cLLeB/lock-in-amplifier/breadboard/breadboard-layout.png

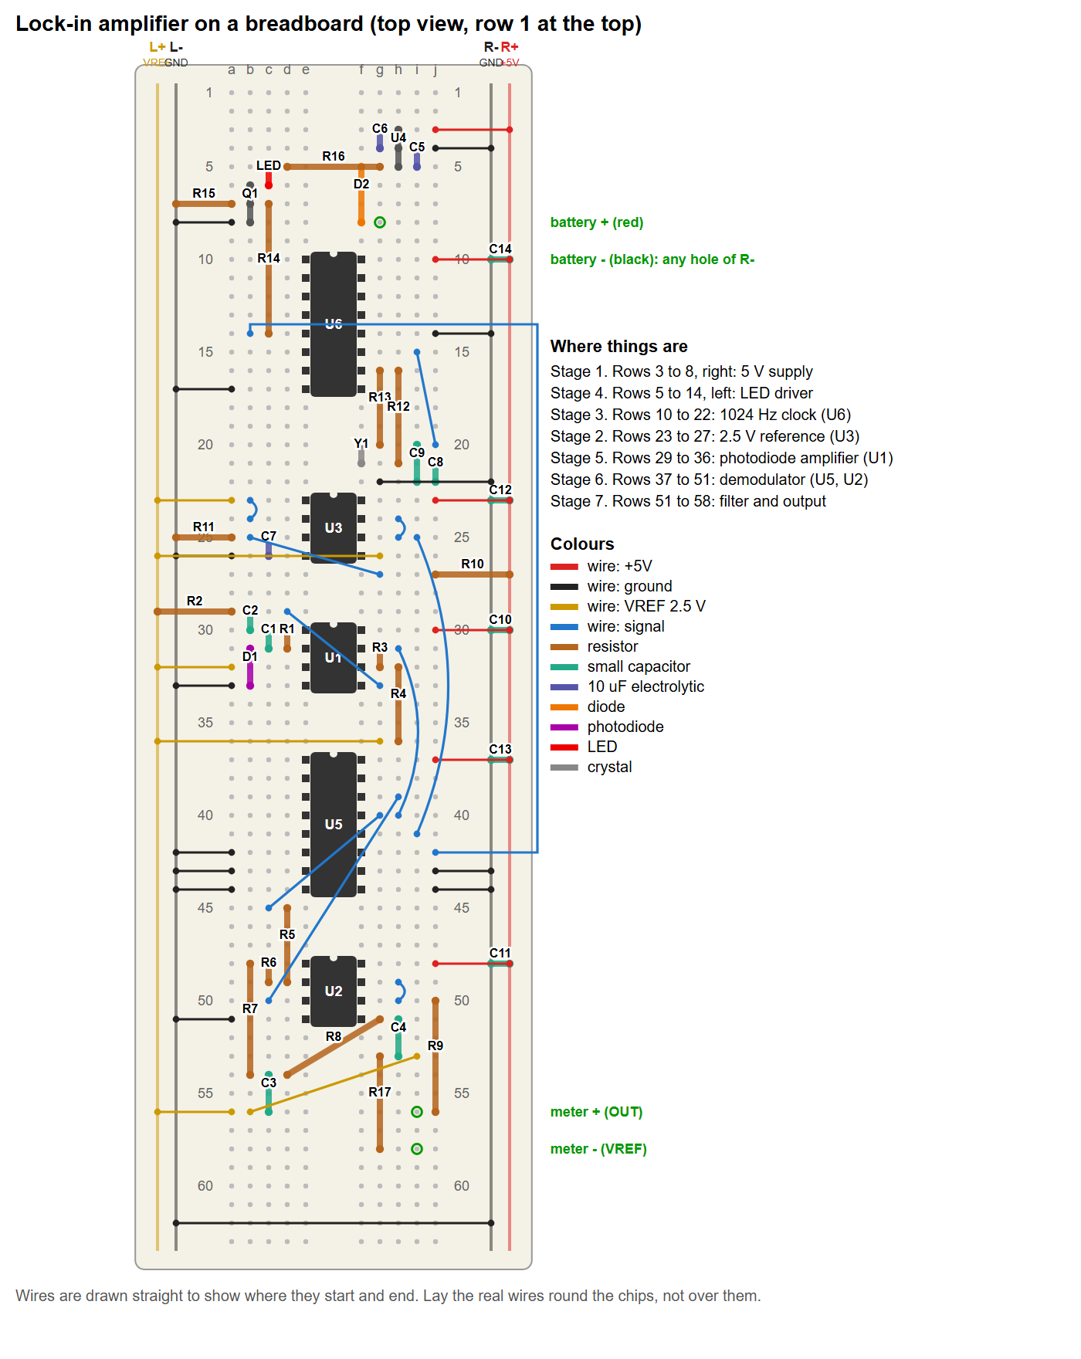
breadboard/breadboard-layout.png
