cLLeB/lock-in-amplifier/kicad/lockin-board.png

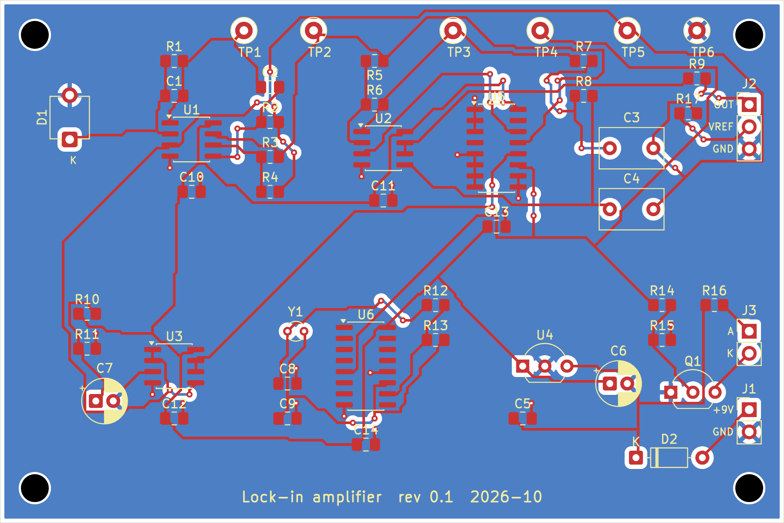
kicad/lockin-board.png
