cLLeB/lock-in-amplifier/kicad/lockin-schematic.png

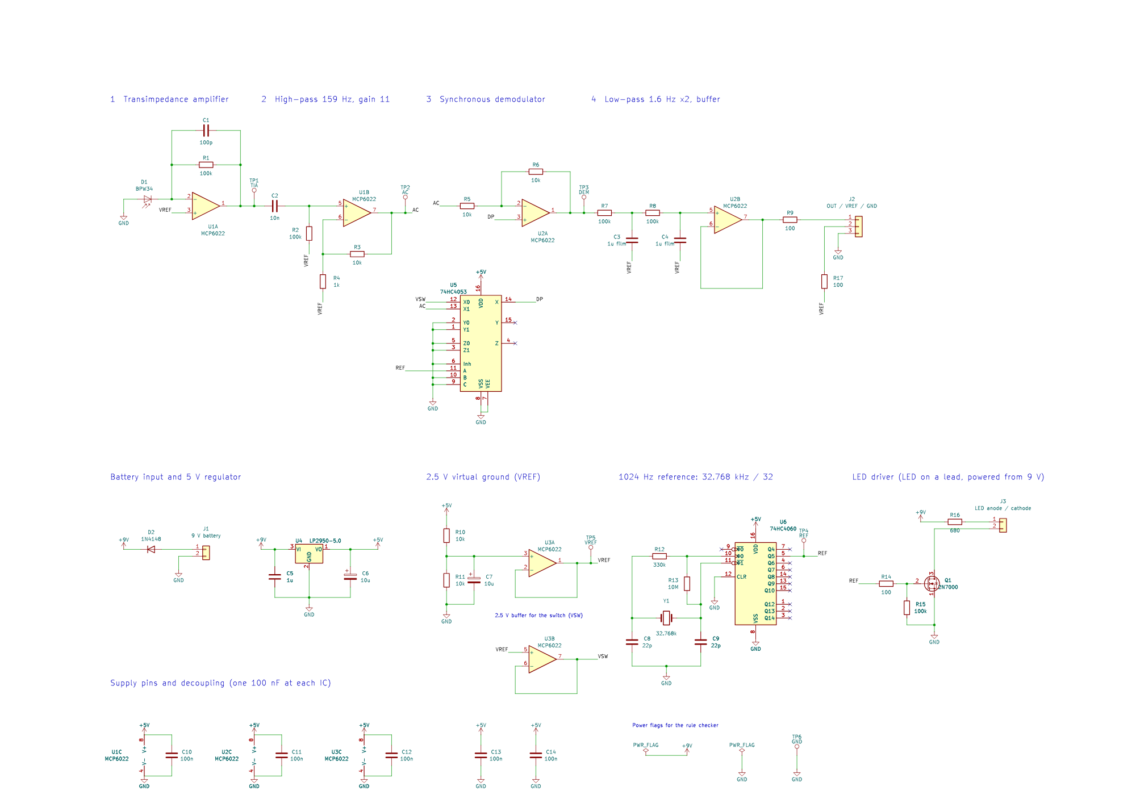
kicad/lockin-schematic.png
