cLLeB/lock-in-amplifier/kicad/bom.csv

Refs | Value | Footprint | Qty
C1 | 100p | Capacitor_SMD:C_0805_2012Metric_Pad1.18x1.45mm_HandSolder | 1
C2 | 10n | Capacitor_SMD:C_0805_2012Metric_Pad1.18x1.45mm_HandSolder | 1
C3,C4 | 1u film | Capacitor_THT:C_Rect_L7.2mm_W4.5mm_P5.00mm_FKS2_FKP2_MKS2_MKP2 | 2
C5 | 1u | Capacitor_SMD:C_0805_2012Metric_Pad1.18x1.45mm_HandSolder | 1
C6,C7 | 10u | Capacitor_THT:CP_Radial_D5.0mm_P2.00mm | 2
C8,C9 | 22p | Capacitor_SMD:C_0805_2012Metric_Pad1.18x1.45mm_HandSolder | 2
C10-C14 | 100n | Capacitor_SMD:C_0805_2012Metric_Pad1.18x1.45mm_HandSolder | 5
D1 | BPW34 | OptoDevice:Osram_DIL2_4.3x4.65mm_P5.08mm | 1
D2 | 1N4148 | Diode_THT:D_DO-35_SOD27_P7.62mm_Horizontal | 1
J1 | 9 V battery | Connector_PinHeader_2.54mm:PinHeader_1x02_P2.54mm_Vertical | 1
J2 | OUT / VREF / GND | Connector_PinHeader_2.54mm:PinHeader_1x03_P2.54mm_Vertical | 1
J3 | LED anode / cathode | Connector_PinHeader_2.54mm:PinHeader_1x02_P2.54mm_Vertical | 1
Q1 | 2N7000 | Package_TO_SOT_THT:TO-92_Inline_Wide | 1
R1,R2,R7,R8,R15 | 100k | Resistor_SMD:R_0805_2012Metric_Pad1.20x1.40mm_HandSolder | 5
R3,R5,R6,R10,R11 | 10k | Resistor_SMD:R_0805_2012Metric_Pad1.20x1.40mm_HandSolder | 5
R4 | 1k | Resistor_SMD:R_0805_2012Metric_Pad1.20x1.40mm_HandSolder | 1
R9,R14,R17 | 100 | Resistor_SMD:R_0805_2012Metric_Pad1.20x1.40mm_HandSolder | 3
R12 | 330k | Resistor_SMD:R_0805_2012Metric_Pad1.20x1.40mm_HandSolder | 1
R13 | 10M | Resistor_SMD:R_0805_2012Metric_Pad1.20x1.40mm_HandSolder | 1
R16 | 680 | Resistor_SMD:R_0805_2012Metric_Pad1.20x1.40mm_HandSolder | 1
TP1 | TIA | TestPoint:TestPoint_Loop_D2.50mm_Drill1.0mm | 1
TP2 | AC | TestPoint:TestPoint_Loop_D2.50mm_Drill1.0mm | 1
TP3 | DEM | TestPoint:TestPoint_Loop_D2.50mm_Drill1.0mm | 1
TP4 | REF | TestPoint:TestPoint_Loop_D2.50mm_Drill1.0mm | 1
TP5 | VREF | TestPoint:TestPoint_Loop_D2.50mm_Drill1.0mm | 1
TP6 | GND | TestPoint:TestPoint_Loop_D2.50mm_Drill1.0mm | 1
U1-U3 | MCP6022 | Package_SO:SOIC-8_3.9x4.9mm_P1.27mm | 3
U4 | LP2950-5.0 | Package_TO_SOT_THT:TO-92_Inline_Wide | 1
U5 | 74HC4053 | Package_SO:SOIC-16_3.9x9.9mm_P1.27mm | 1
U6 | 74HC4060 | Package_SO:SOIC-16_3.9x9.9mm_P1.27mm | 1
Y1 | 32.768k | Crystal:Crystal_C26-LF_D2.1mm_L6.5mm_Vertical | 1
