cLLeB/lock-in-amplifier/3D-prints/Lock-in amplifier/lockin-led-holder.stl

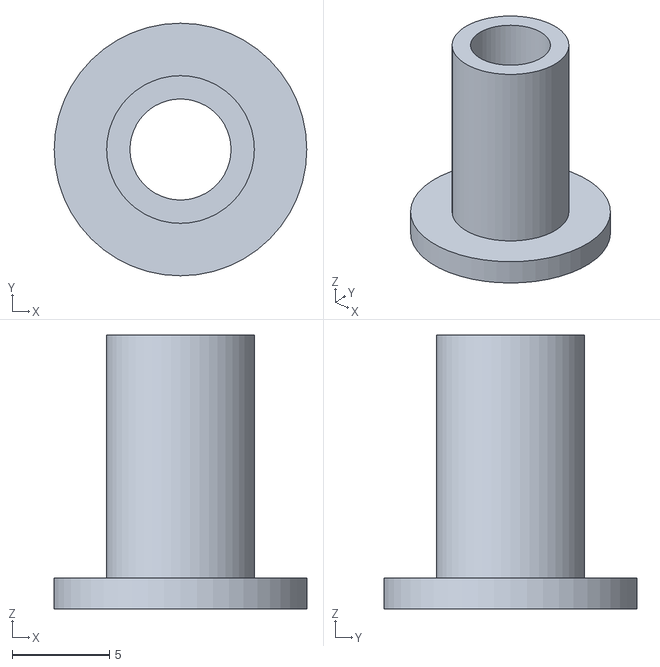
[picture p6: CAD file, 2026-11-02]
3D-prints/Lock-in amplifier/lockin-led-holder.stl
13.0 x 13.0 x 14.1
