cLLeB/lock-in-amplifier/case/lockin-base.stl

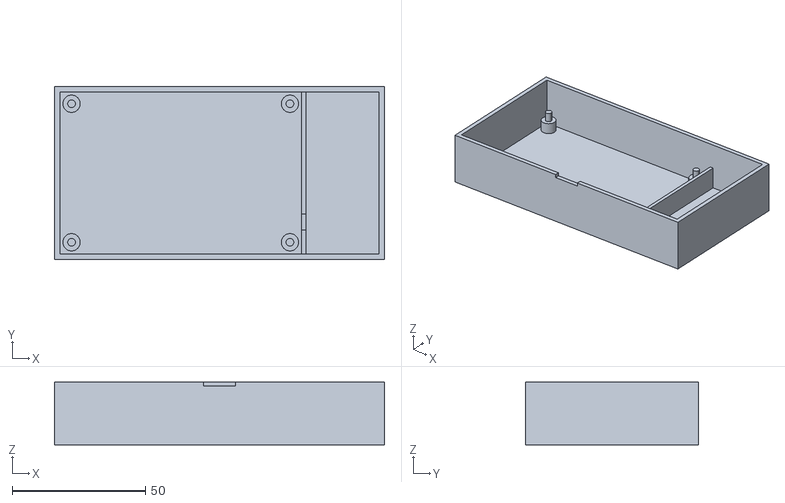
[picture p7: CAD file, 2026-11-02]
case/lockin-base.stl
123.9 x 64.8 x 23.6
