cLLeB/lock-in-amplifier/case/lockin-lid.stl

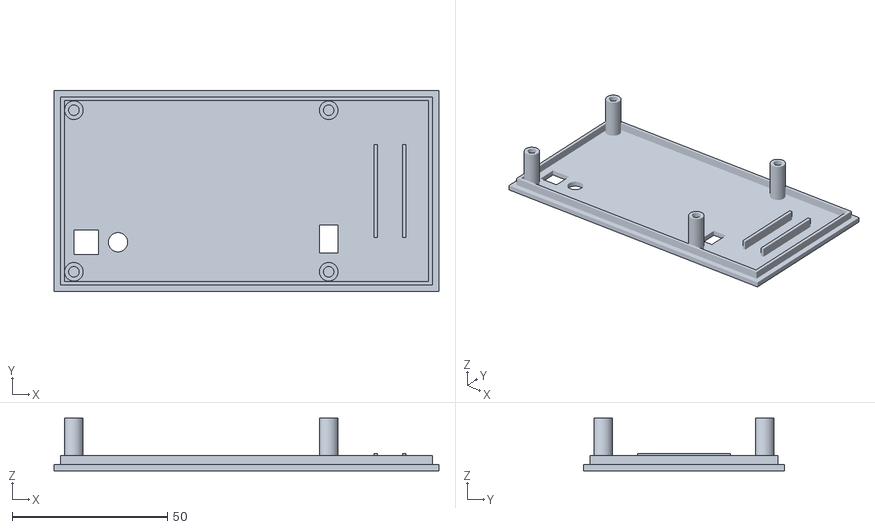
[picture p8: CAD file, 2026-11-02]
case/lockin-lid.stl
123.9 x 64.8 x 17.0
