cLLeB/lock-in-amplifier/3D-prints/Lock-in amplifier/Lock-in amplifier 3D view.html

Loading the 3D models...

# Boards in their cases

Smart socketLock-in amplifier

Lift the lid Case see-through Lid Base

Drag to turn, right-drag to move, scroll to zoom.
